BatuhanGunes/SmartBall/README(turkish).md

**Dil :** [English](https://github.com/BatuhanGunes/SmartBall) / Turkish

# Smart Ball

Bu proje, bir futbol takımı antrenörünün futbol takımı oyuncularını antreman sırasında takip edebilmesi için tasarlanmıştır. Özellikle pas ve şut antremanları sırasında isabet ve hız değerlerinin ölçümlenebilmesi amaçlanmıştır. Proje fiziksel ve yazılım olmak üzere iki kısımdan oluşmnaktadır. Fiziksel kısım sensörler ile topu algılayarak sonuçları yazılıma aktarmakta, yazılım kısmı ise gelen verileri işleyerek kaydetmektedir. Veriler yazılımın bulunduğu cihazda depolanır. Antremanlar gerçekleştirildikten sonra cihazda depolanan veriler her futbolcu için ayrı ayrı değerlendirilerek gelişimleri gözlemlenilebilir. Böylelikle antrenör takımını daha kolay analiz edebilmektedir.

```
Projenin oluşturulma tarihi : Haziran 2018
```

## Ekran Görüntüleri

   

    

 

## Başlangıç

Projeyi çalıştırabilmek için proje dosyalarının bir kopyasını yerel makinenize indirin. Gerekli ortamları ve elektronik malzemeleri edinin. Edindiğiniz malzemeler için gerekli devreyi kurun. Herhangi bir android cihaza yazılımı yükleyin. Yazılım üzerinden devre ile iletişimi sağlayın ve kullanmaya başlayın.

### Gereklilikler

- Devre için gerekli sensörler ve malzemeler
- Android yazılım sistemine sahip bir cihaz
- Android Studio
- Arduino
- Arduino IDE

Projeyi çalıştırabilmek için ilk olarak [Android Studio](https://developer.android.com/studio) adresinden sisteminize uygun IDE yazılımının herhangi bir sürümünü edinerek yerel makinenize kurun. Daha sonra yerel makinenize indirdiğiniz android yazılım için olan dosyaları bu ortamda açın. Gerekli ayarlamarı yaptıktan sonra uygulamanın apk uzantısını elde edin. Bu dosyayı android yazılıma sahip bir cihaza yükleyin.

Arduino için gerekli malzemeleri edinin ve devreyi oluşturun. Arduino için [Arduino IDE](https://www.arduino.cc/en/main/software) adresinden sisteminize uygun IDE yazılımının herhangi bir sürümünü edinerek yerel makinenize kurun. Arduino-pc bağlantısını gerçekleştirerek işlemciye arduino yazılımı arduino IDE ile yükleyin. Çalışır durumda olan devre ile uygulama arasında bluetooth bağlantısını oluşturun. uygulamayı kullanmak için yeni bir oyuncu oluşturun. Sistemi test etmek için oluşturulan oyuncu ile antremana başlayın. Bir top yardımıyla sistemi test edin.

## Yazarlar

* **Batuhan Güneş**  - [BatuhanGunes](https://github.com/BatuhanGunes)

Ayrıca, bu projeye katılan ve katkıda bulunanlara [contributors](https://github.com/BatuhanGunes/SmartBall/graphs/contributors) listesinden ulaşabilirsiniz.

## Lisans

Bu proje Apache lisansı altında lisanslanmıştır - ayrıntılar için [LICENSE.md](https://github.com/BatuhanGunes/SmartBall/blob/master/LICENSE) dosyasına bakabilirsiniz.
