BatuhanGunes/SmartBall/SmartBall_Description.pdf

Arduino projesi için araştırma

Proje başlangıcında belirli bir alana giren cismin hızının ölçülmesi, ölçülen değerlerin tablet veya telefon aracılığıyla kullanıcıya gösterilmesi amaçlandı. Örneğin bir futbolcu kaleye şut çekiyor ve antrenör futbol topunun kaleye hangi hızla girdiğini elindeki tabletten görebiliyor olacak. Bu projenin hayata geçirilebilmesi için hangi malzemelerin gerektiğini ve nasıl bir yol izlenmesi gerektiğinin belirlenmesi için araştırmalar yaptım

Araştırmalarım sonucunda yapılan kodlamaların derlenebilmesi için işlemci(Board) olarak arduino uno’yu seçtim. Herkesin de bildiği üzere herhangi bir cimin hızının ölçülebilmesi için cismin aldığı yolun ve bu yolu aldığı zamanın bilinmesi gerekmektedir. Kısacası cismin aldığı yolu ve zamanı hesaplayabileceğim sensörleri araştırmaya başladım.

Sensör araştırmalarım doğrultusunda Hc-Sr04 (ulturasonik mesafe sensörü) (Şekil 4.1), Ldr (foto direnç sensörü) (Şekil 4.2) ve HB100 (mikrodalga doppler radar sensörü) (Şekil 4.3) sensörlerinin projede kullanılabileceğini düşündüm. Cihaz ile tablet arasındaki iletişimi sağlamak için wi-fi ve bluetooth olmak üzere 2 seçenekten bluetooth modülünün proje için daha verimli olabileceğini düşündüm. Bluetooth modüllerini araştırdığımda Hc05 ve Hc06 olarak iki farklı modeli olduğunu gördüm. Bu modüller arasındaki farkları araştırdığımda Hc05 modülünün Hc06 modülünden farklı olarak kendi kendine iletişim başlatabileceğini bu yüzden Hc05 modülünün (Şekil 4.4) projeye daha uygun olacağını gördüm.

Bütün bu araştırmalarımın sonuçlarını raporlayarak, raporumu yetkili kişiye sundum. Verdiğim bilgiler doğrultusunda projeye nasıl devam etmemiz gerektiği, ne gibi malzemeler kullanmamız gerektiğini ve bu malzemelerin maliyetleri hakkında fikir alışverişinde bulunduk. Yaptığımız toplantı sonucunda 2 adet Hc-Sr04 (ulturasonik mesafe sensörü) ile 2 farklı noktada geçen cismi algılayıp bu iki nokta arasında geçen süreyi bulmak amaçlandı. Sensörler arasındaki mesafe bilindiği için buradan hız bulanabileceği sonucuna varıldı. Seçtiğim board ve bluetooth modülü uygun bulundu.

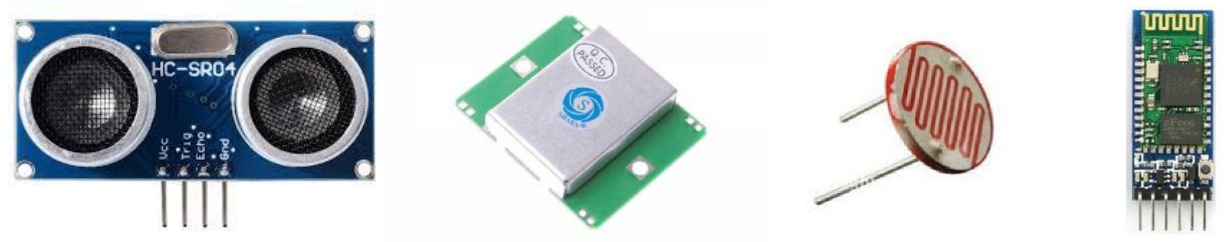
[picture p11: figure]

(Şekil 4.1) | (Şekil 4.2) | (Şekil 4.3) | (Şekil 4.4)

Devre şemasının çizilmesi ve malzemelerin alınması

Gerekli Malzemelerin belirlenmesinden sonra devre şemasını sanal ortamda modelledim (Şekil 5.1). Alınması gereken malzemeleri listeledim ve temin ettim. Alınan malzemeler;

- Arduino uno
- Hc-Sr04 (ulturasonik mesafe sensörü) x 2 adet
- Hc-05 (bluetooth modülü)
- Jumper erkek-erkek kablo
- Breadboard
- Dirençler

Alınan malzemeler, oluşturulan modelleme doğrultusunda breadboard üzerinde bağlantılarını gerçekleştirdim. Ardından arduino’nun programlanabilmesi için gereken yazılımsal ortamın yani Arduino IDE’nin kurulumunu yaptım. Sensörlerin ilk testi için gereken kodlamaları yaptım (Şekil 5.2). Yapılan kodlamaları arduino’ya yüklenip sensörlerin doğru çalışıp çalışmadığını, hassasiyetleri ve algı mesafelerini test ettim. Sorunsuz çalışan sensörler yetkili kişi tarafından da teste tabi tuttu. Yapılan testler sonucunda yüksek hızlarda sensörlerin topu görmediğini fark ettik.

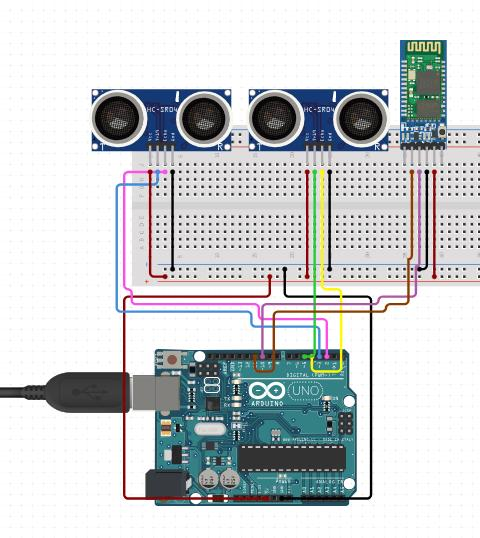
[picture p12: figure]
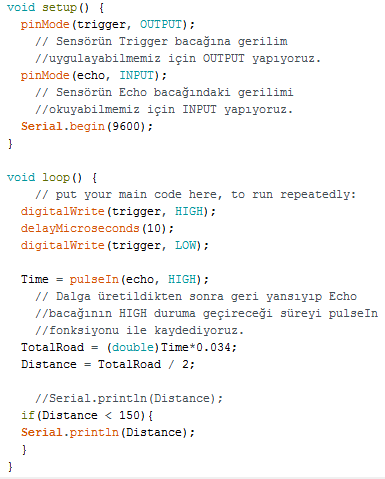
[picture p13: figure]

(Şekil 5.1) | (Şekil 5.2)

Çift sensör ile yatay düzlemede hız hesaplama

Yapılan testler sonucu sensörlerin cisimleri yüksek hızlarda göremediği tespit edilmişti. Bu hassasiyetin daha net ölçülebilmesi ve hangi hızlara kadar görüş sağladığını görmek amacıyla hız hesaplamalarına geçildi. Bunun için sensörlerin arasının ölçülüp 10cm’de sabitledikten sonra (Şekil 6.2) zaman tespiti için gerekli kodlarını yazdım. Milisaniye cinsinden bulunan zaman değerini saniyeye çevirip, kendi belirlediğim 10cm uzunluğa bölünmesi ile ölçülen hız değerlerini ekrana yazdırdım. Yapılan bu kodlamaların bir kısmı (Şekil 6.3 ve Şekil 6.4)’de görülebilir.

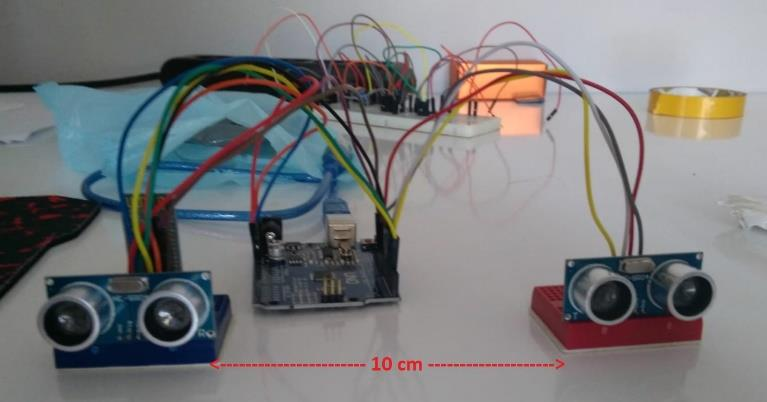
[picture p14: figure]
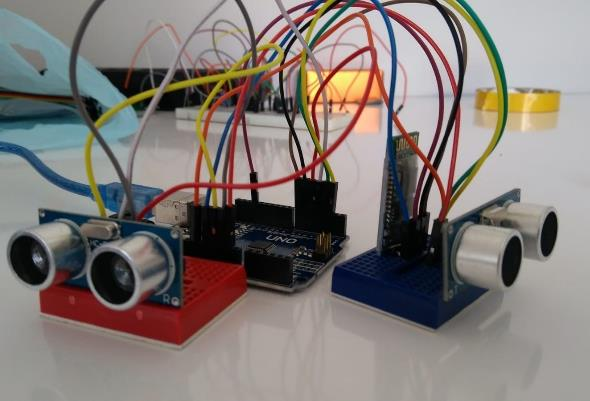
[picture p15: figure]

(Şekil 6.1) | (Şekil 6.2)

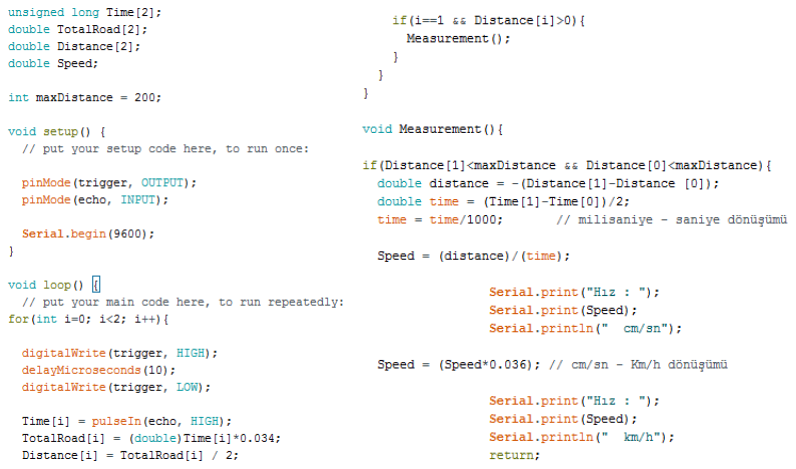
[picture p16: figure]

(Şekil 6.3) | (Şekil 6.4)

Tek sensör ile karşıdan gelen cismin hızını hesaplama

Yapılan sistem tekrar teste tabi tutuldu. Yapılan testler sonucu daha net görülmekte olan sensör hassasiyetinin, topu 15 km/h hızdan sonrasında nadiren gördüğü, 20 km/h hızdan sonra hiç görmediği fark edildi. Bunun üzerine Hc-Sr04 ulturasonik mesafe senörünün gelişmiş versiyonlarını araştırarak, bu sensörlerin fiyatları tartışıldı. Fiyatları fazla görülen bu sensörler projeye uygun görülmedi.

Sonuca ulaşmak için sensör değişikliği yerine sistemin çalışma prensibinin değiştirilebilirliği hakkında fikirler ürettim. Öne sürdüğüm bu fikirlerin içerisinden sensörün karşıdan gelen cisme odaklanması ve bunun üzerinden hız ölçümü yapmasını kararlaştırdım. Bu uygulamayı hayata geçirebilmek için araştırmalar yaptım.

Araştırmalarımın sonucunda sensörün karşıdan gelen cismi 2 kez algılayıp, cismin mesafelerini bir diziye atadıktan sonra uzaklıklar arasındaki farkı mesafe olarak kabul etmek ve cismin bu mesafeyi ne kadar zamanda geçtiğini ölçerek, cimin hızının bulmayı amaçladım. Bu doğrultuda gereken kodlar yazdım (Şekil 7.1 ve Şekil 7.2) ve devre üzerinde yapılması gereken değişiklikleri (Şekil 7.3) yaptım.

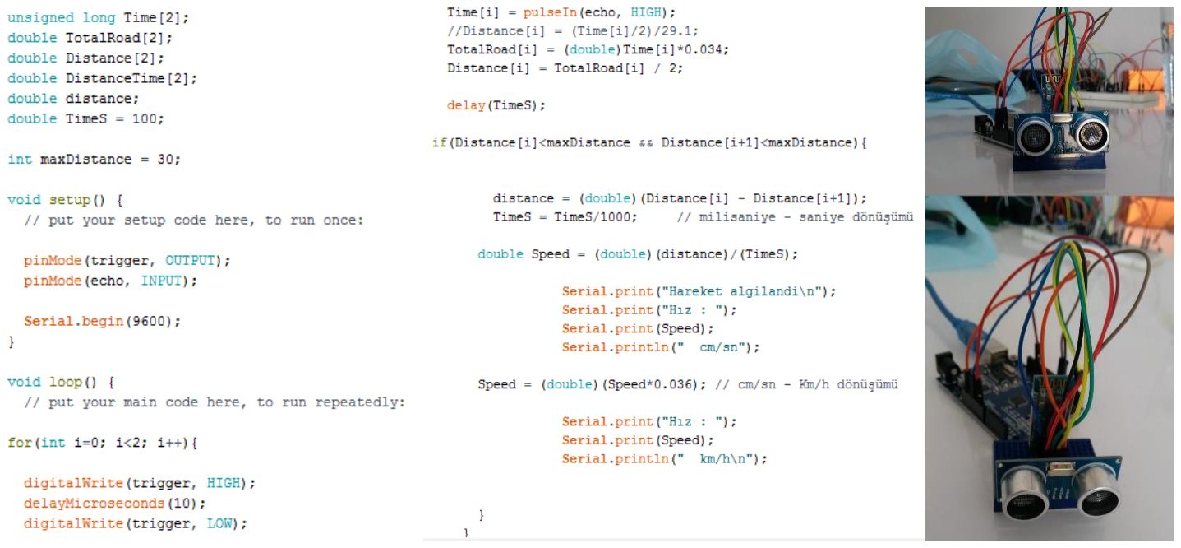
[picture p17: figure]

(Şekil 7.1) | (Şekil 7.2) | (Şekil 7.3)

Giriş-Çıkış sensör kontrol düzeni

X-bandında hız ölçen sistemin son düzenlemelerini yaptıktan sonra top ile test etme aşamasına geçtim. Yapılan testler doğrultusunda sensörün bu şekilde kullanılmasının algılamadaki hassasiyetini arttırdığı gözlemledim. Sensörün 20 km/h’den sonrasını nadiren, 30 km/h’den sonrasını hiç algılamadığını tespit ettim. Hassasiyetin arttırılması doğrultusunda algılama alanını daralttığını gözlemledim. Alanın daralması proje kapsamında maliyeti arttırmasından ve uygulanabilirliği azaltmasından dolayı bu yöntemden vazgeçildi.

Yapılan testler sonrasında projeye yeni problemlerin eklendiği ve bu problemler doğrultusunda nasıl bir çözüm yolu uygulanması gerektiği konusunda araştırmalar yaptım. Problemlerden biri olan algılama alanının nasıl arttırılabileceği yönünde sensörlerin arkalı önlü koyularak topun hem geliş yönünde hem de çıkış yönünde algılanmasıyla hassasiyetin ve alanın arttırılabileceğini ön gördüm.

Böylelikle sensörlerden biri topun ilk girişini algılayacak ve diğerinde çıkış yönünde bir algılama sağlayarak aradaki hız hesaplanacaktı. Bu doğrultuda proje için çalışmaya başladım. Gerekli devre düzenini kurup kodlar üzerindeki değişiklikleri (Şekil 8.1 ve Şekil 8.2) yaptım. Problemlerden bir diğeri olan uygulanabilirlik projenin ilerleyen aşamalarına bırakıldı.

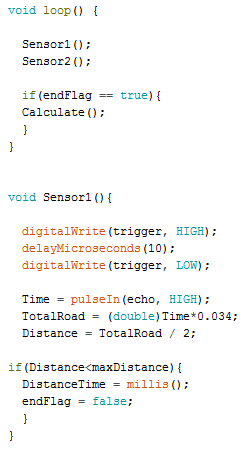
[picture p18: figure]
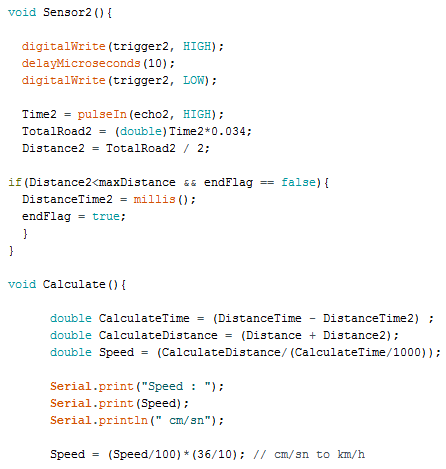
[picture p19: figure]

(Şekil 8.1) | (Şekil 8.2)

Arduino projesinin minyatür kalede test edilmesi

Yapılan giriş-çıkış algılama sisteminin hassasiyetinin ölçülebilmesi için minyatür kale üzerinde testlerine başladım. Sistemin minyatür kaleye montajından sonra topun hızı ölçülmeye başladım. Testler sonrasında kalenin en alt kısmından geçmekte olan cisimleri görmediği ve algı alanın yetersiz olmasından dolayı sistemin iyileştirilmesi için çalışmalar yapılması istenildi. Testler bitirilmeden önce sistem x-bandında ölçüm yapan tek sönsör haline çevrilerek kalenin arkasına koyulmasına ve test edilmesine karar verildi. Bu yöntem verimli olmadığı için iptal edildi.

Algı alanını genişletmek adına kalenin üst direğine aralarındaki mesafe 33cm olacak şekilde 3 adet sensör monte ettim (Şekil 9.1, Şekil 9.2, Şekil 9.3 ve Şekil 9.4). Aynı zamanda kodları iyileştirmek için çalıştım. Çalışmalar sırasında zaman tespitinde sorunlarla karşılaştım. Bu sorunları çözmeye çalıştım. Zamanlama sorunu çözüldükten sonra test aşamasına geçtim. Test sonuçlarının doğrultusunda verimli sonuç alamadım. Bunun üzerine kullanılan Hc-Sr04 ulturasonik mesafe sensörünün projeye uygun olup olmadığı tartışıldı.

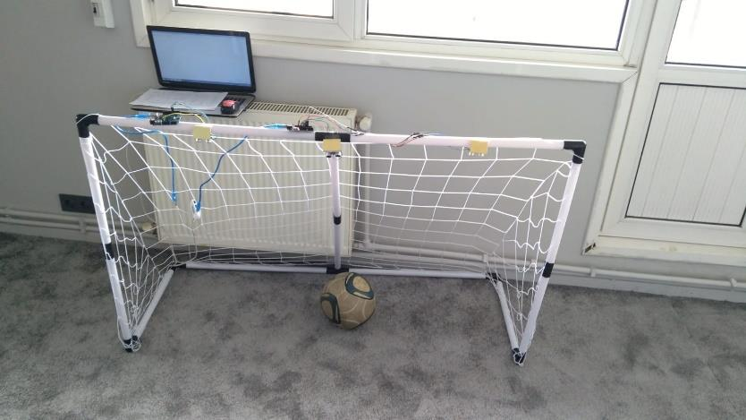
[picture p20: figure]
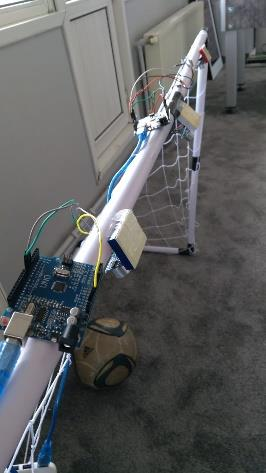
[picture p21: figure]

(Şekil 9.1) | (Şekil 9.2)

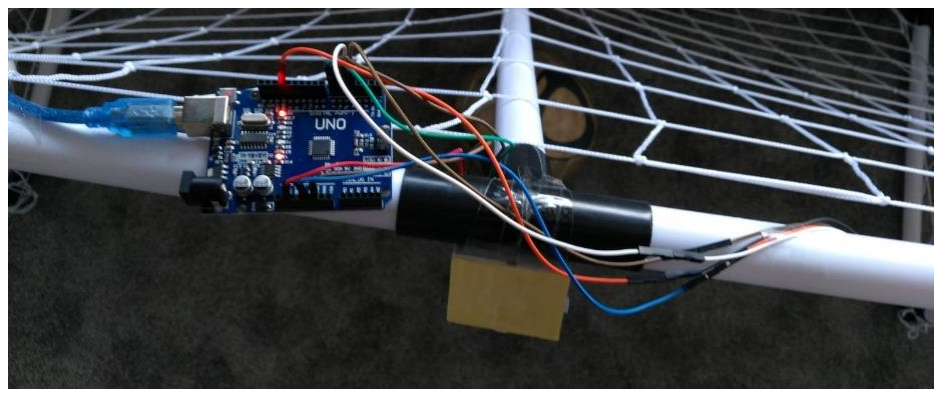
[picture p22: figure]
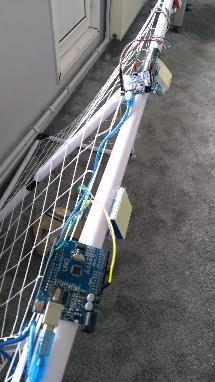
[picture p23: figure]

(Şekil 9.3) | (Şekil 9.4)

Farklı sensörlerin araştırılması ve ldr sensörünün testi

Sensörler istenilen hızları ölçmek için yeterli olmadığından kullanılan sensörlerin proje kapsamında doğru seçim olup olmadığı gündeme getirilmişti. Sensörün proje için doğru olup olmadığı araştırırken bir yandan da farklı sensörleri araştırmaya devam ettim.

Proje başında araştırılan sensörlerden LDR (light dependent resistor) sensörü için devre oluşturulup gerekli kodlamalar (Şekil 10.1 ve Şekil 10.2) yapıldı. Sensörün ışık ortamıyla birebir etkileşimi olduğundan sensörün dış ortamda kullanılamayacağı kararlaştırıldı. Dış ortama uygun olması adına sistemin ilk 1 milisaniyesinde ortamın ışık oranının, ortalamasının alınıp hesaplamaya aktarılması fikrini öne sürdüm fakat yöntemin sağlıksız olacağı, bu yüzden ldr (Foto direnç) sensörünün projeye uygun olmadığı kararlaştırıldı. Bunun üzerine proje için tekrar yeni sensörler araştırmaya başladım.

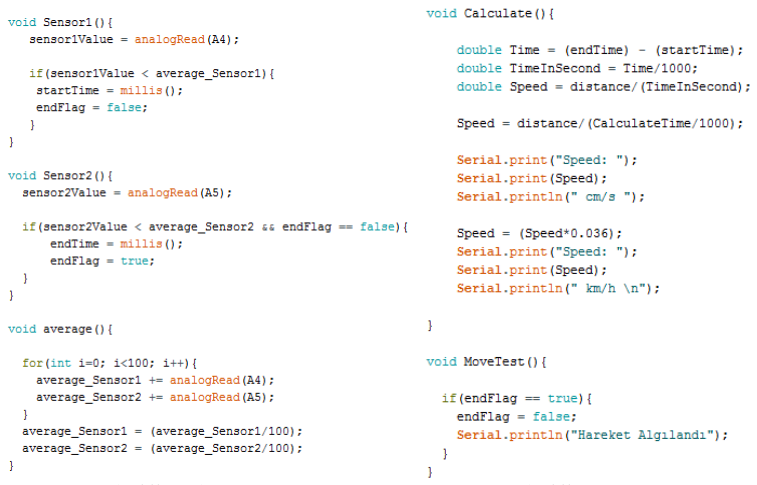
[picture p24: figure]

(Şekil 10.1) | (Şekil 10.2)

Hb100 mikrodalga doppler sensörü ile hız ölçümü

Tekrar arduino projesine döndüm. Proje için uygun sensör aramaya başladım. Araştırmalarım sonrasında Hb100 mikrodalga doppler radar sensörünün kullanılmasına karar verdim. Hb100 ve arduino ile yapılmış olan radar silahı projelerini araştırdım ve örnek aldım. Radar silah projelerinin projemize uygulanabilirliğini kontrol ettim.

Hb100’ün sinyal yayması için gerekli amfi devresi tasarımlarını inceledim. Devre şeması çıkarttım (Şekil 13.1). Arduino’ya uyumlu versiyonunu bulamadığım için cihaza pinler lehimleyerek uygun hale getirdim (Şekil 13.2). Gerekli bağlantıları breadboard üzerinde oluşturduktan (Şekil 13.3) sonra kodlarını yazılmaya başladım (Şekil 13.4). Devrenin testini gerçekleştirdim. Testler sonucu verilerin yanlış geldiğini tespit ettim.

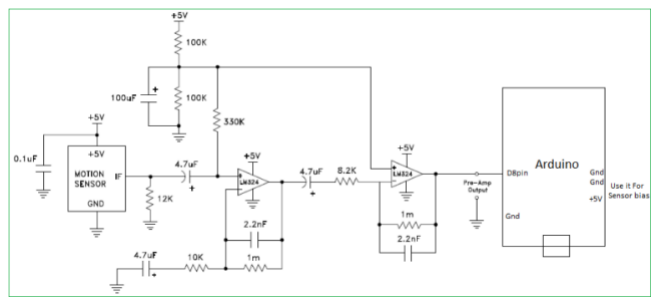
[picture p25: figure]

(Şekil 13.1)

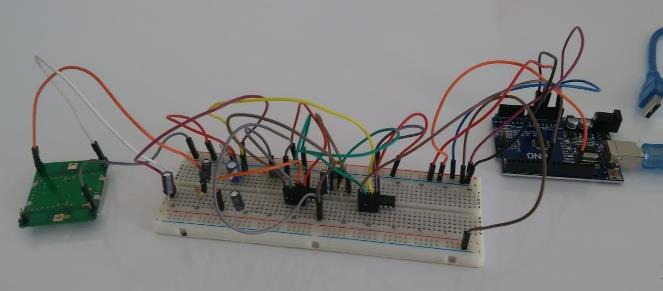
[picture p26: figure]
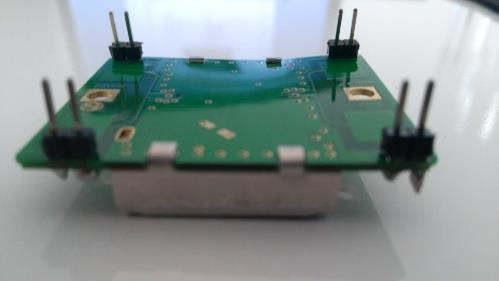
[picture p27: figure]

(Şekil 13.2) | (Şekil 13.3)

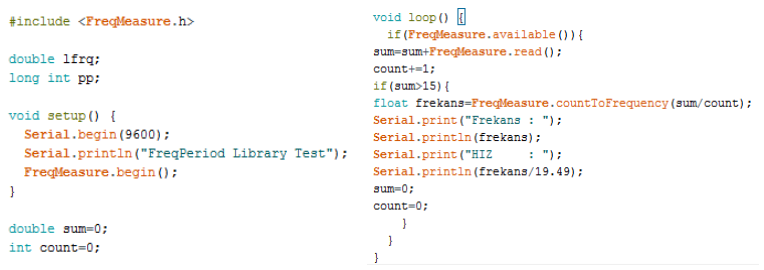
[picture p28: figure]

(Şekil 13.4)

Hb100 hatalarının tespiti ve Pır Sensörü

Hb100 mikrodalga doppler sensöründen veri alamadım. Zaman zaman aldığım verilerin ise hatalı olduğunu belirledim. Bunun sebeplerini araştırdım. Devre bağlantılarını kontrol ettim. Kodları kontrol ettim. Bir sorunla karşılaşmadım ve hatanın nedeni bulamadım. Bu yüzden devreyi breadboard üzerinde sıfırdan yapmaya başladım. Bağlantıları tekrar kontrol ettim. Fakat sonuç değişmedi. Multimetre ile bağlantıları kontrol ettim. Verilerin yanlış gelmesinin nedenini bulamadım. Bu sorunun nedeni üzerine araştırmamalar yaptım. Araştırmalar sonrasında nedeni bulunamayan hatalardan dolayı Hb100 projeden çıkarıldı.

Hb100 kullanılmaktan vazgeçilerek yerine HC-SR501 ayarlanabilir IR hareket sensörü (PIR) kullanılmasına karar verildi. Bunun için gerekli araştırmaları yaptım. Çalışma prensibini araştırdım (Şekil 14.1 ve Şekil 14.2). Sensörü tedarik ettim. Sensör zaman ve hassasiyet anahtarlarını en düşüğe alarak “I” moduna ayarladım. İlk testler için gerekli bağlantıları yaptım (Şekil 14.3) ve sensörün algılama kapasitesini ölçmek için gerekli kodları yazdım (Şekil 14.3).

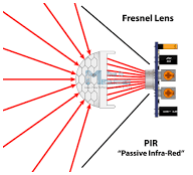
[picture p29: figure]
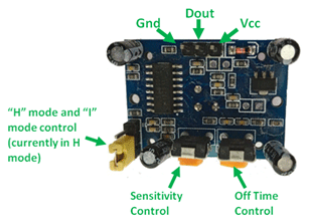
[picture p30: figure]

(Şekil 14.1) | (Şekil 14.2)

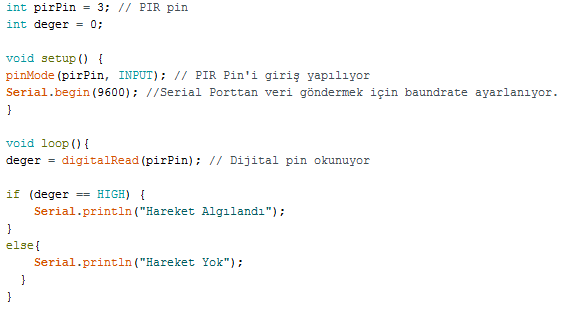
[picture p31: figure]
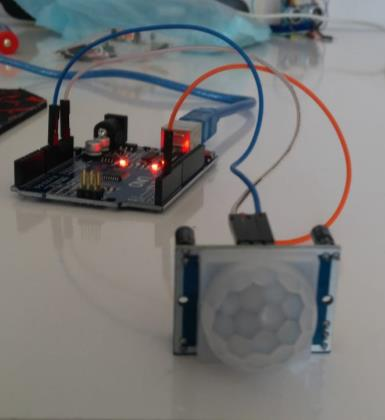
[picture p32: figure]

(Şekil 14.3) | (Şekil 14.3)

Hareketin süresini tutma ve Monster Notebook akışı

PIR Sensörü ile algılama kapasitesini ölçtükten sonra önünden geçen cismin hareketini ne kadar sürede bitirdiğini hesaplamaya geçtim. Bunun için kodlamalar yaptım (Şekil 15.1). Fakat PIR sensörünün çalışma prensibinden kaynaklanan sayma özelliği hareketin bitmesinden sonra 4 saniye daha high konumunda kalmasına neden olmaktaydı. Bu durum hız hesaplarken sorun çıkartacağından dolayı hesaplama sırasında bulunan süreden 4 saniye çıkartarak işlem yaptım. Hesaplamada uyguladığım bu yöntem cihazın 4 saniyelik bir gecikme ile cevap vermesine yol açtı. Gecikmeyi nasıl önleyebileceğim hakkında çalışmalara başladım. Aynı zamanda projenin nasıl devam etmesi gerektiğine ilişkin yetkili kişilerden fikirler aldım.

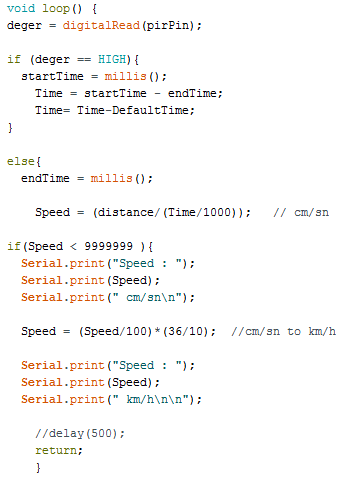
[picture p33: figure]

(Şekil 15.1)

Android uygulaması ile bluetooth cihazına bağlanma

Android Studio yükleyerek SmartBall adlı bir uygulama oluşturmaya başladım. Açılış sayfasında butonlar koyarak butonların farklı activity’lere geçiş yapmalarını sağladım. Arduino’dan gelen verileri işleme sokmak için ilk olarak uygulama ile Ardiuno’nun bluetooth modülünün (Hc-05) telefon ile eşleşmesini sağlamak için gerekli kodları yazdım (Şekil 16.1). Uygulamanın bluetooth özelliğini kullanabilmesi için gerekli izinleri kodladım. Yapılan işlemler sonucunda uygulamanın çalışma esnasında telefonun önceden eşleştirilmiş bluetooth cihazlarını görebilmesi ve bu cihazlara bağlanmasını sağladım. Oluşabilecek hatalardan bluetooth cihazına bağlanamama, telefonun bluetooth özelliğinin kapalı olması veya uygulamanın çalışması sırasında bağlantının kopması gibi durumların hata vermesi durumlarında uygulanılacak senaryolar oluşturdum ve bu senaryoları kodladım (Şekil 16.2).

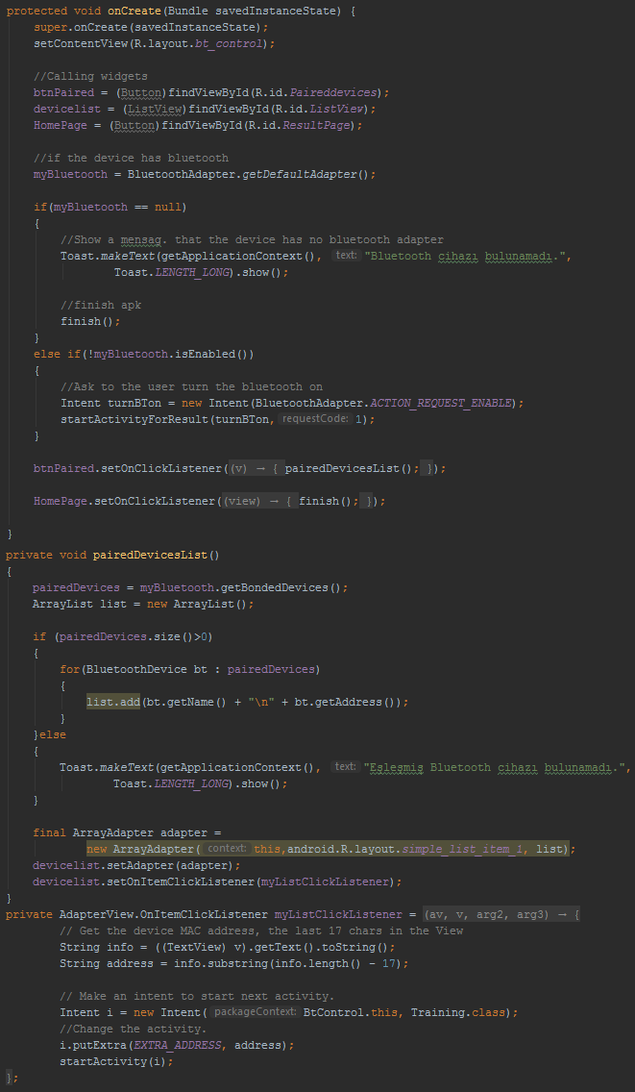
[picture p34: figure]
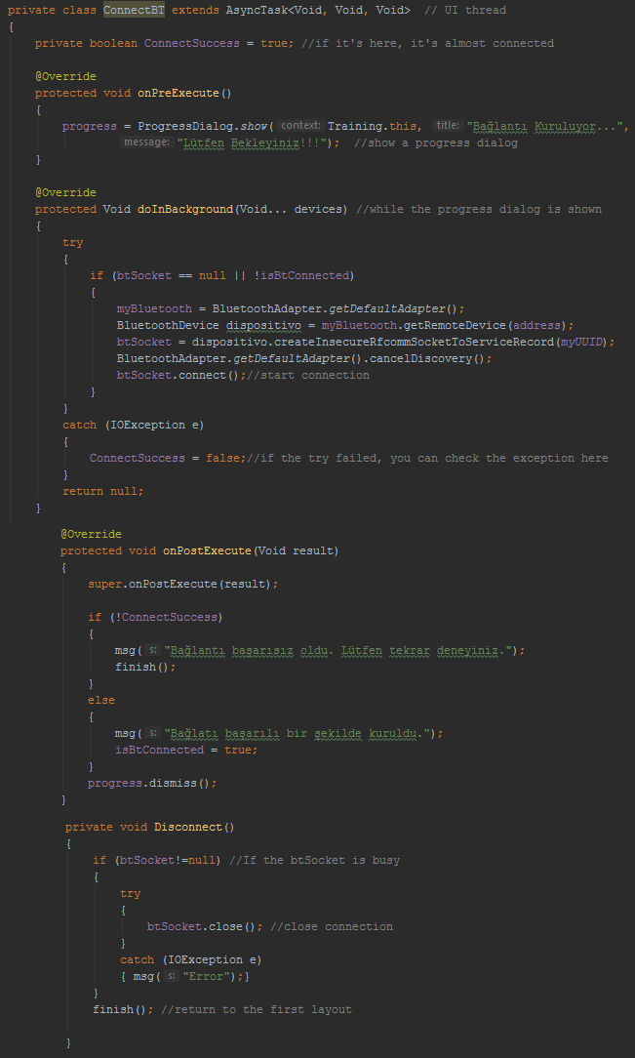
[picture p35: figure]

(Şekil 16.1) | (Şekil 16.2)

Android uygulamasında SQLite işlemleri

Uygulama içerisinde SQLite ile yeni bir veri tabanı ve bu veri tabanına bağlı 2 adet tablo oluşturdum (Şekil 17.1). Bu tablolardan ilki uygulama içerisindeki kişilerin verilerini, diğeri ise bu kişilerin antrenman bilgilerini tutmaktadır. Bu tablolara veri ekleme, veri silme, güncelleme ve listeleme işlemlerini gerçekleştirmek için gerekli kodlamaları yaptım. Daha sonra bu işlemlerin kullanıcı tarafından görülebilecek ve kullanabilecek haline getirdim (Şekil 17.2). Bu işlemlerin ön taraftaki activity tasarımlarını yaptım (Şekil 17.3).

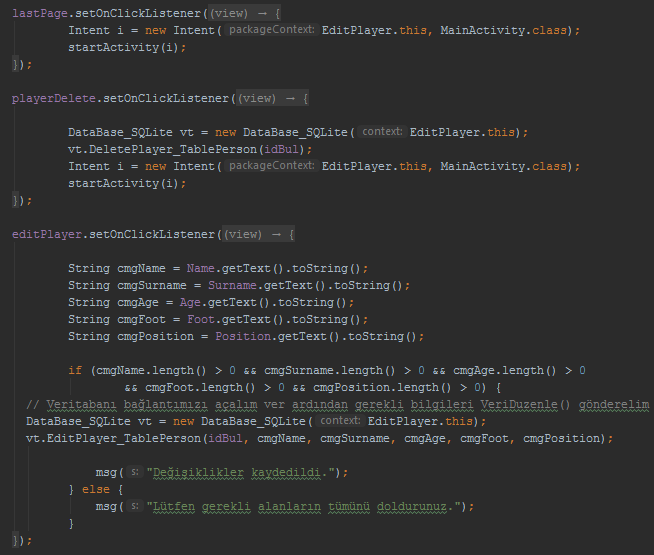
[picture p36: figure]
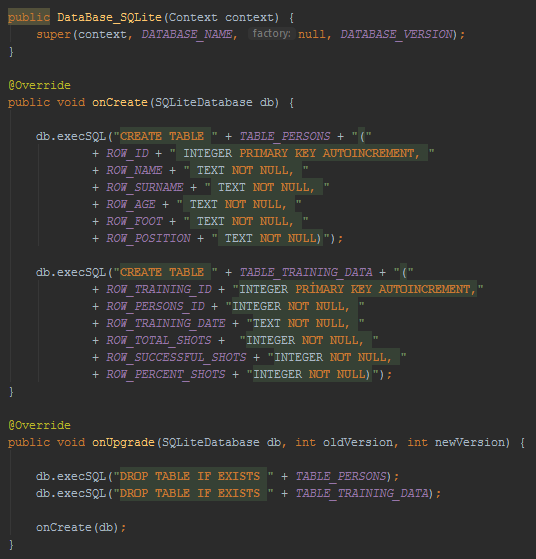
[picture p37: figure]

(Şekil 17.1) | (Şekil 17.2)

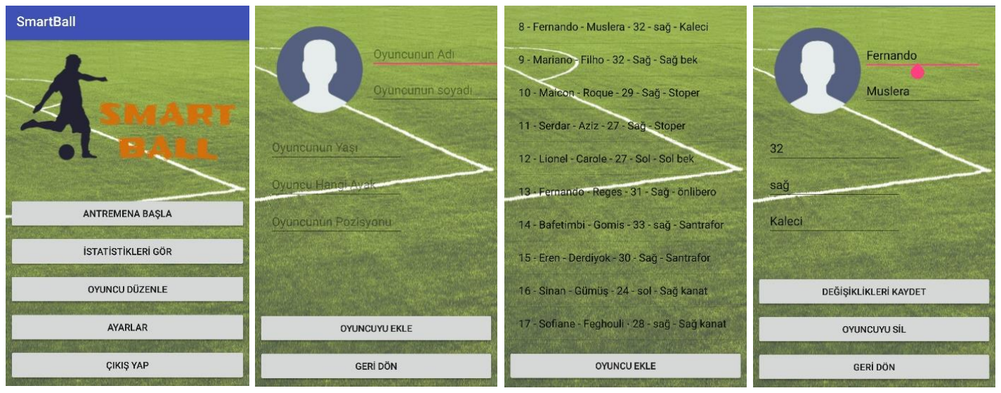
[picture p38: figure]

(Şekil 17.3)

Arduino verilerinin işlenmesi ve uygulama tasarımı

Arduino ile oluşturduğum sistem algı alanından bir nesne geçmesini algılamaktaydı. Bu cihazı kalenin üst kısmana ekleyerek kaleye giren topların hareketini algılayıp, verileri android projemize aktarıp oyunculara göre tutmak amaçlanmıştı. Bunun için oyuncuları tutma işlemlerini daha önceden gerçekleştirdik.

Sırada gelen verileri oyunculara göre tutma ve bunları listeleme işlemi kaldı. Bir panel oluşturarak (Şekil 18.1) antrenmanı başlatıp bitirdiğimizde toplam isabetli şut sayısını, toplam şut sayısını, antrenmanın yapıldığı tarihi, oyuncuyu ve isabet yüzdesi verilerini işlemlere sokup genel sonuçları kullanıcıya göstermek için gerekli kodlamaları yaptım (Şekil 18.2). Aynı zamanda kullanıcının bu zamana kadar yapılan tüm antrenmanları oyunculara göre gözlemleyebileceği bir panel de hazırladım. Uygulamanın genel tasarımı ile ilgili iyileştirilmeler yaptım.

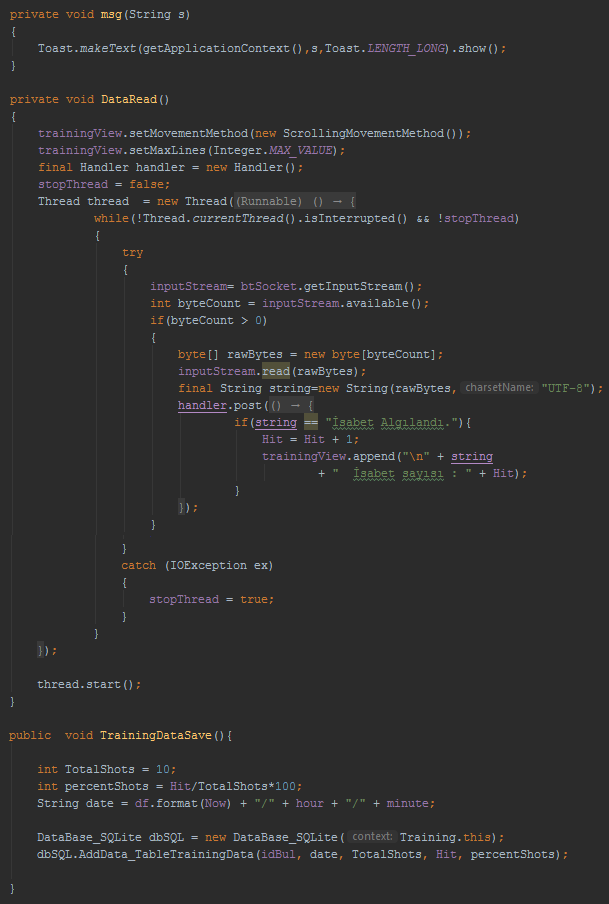
[picture p39: figure]
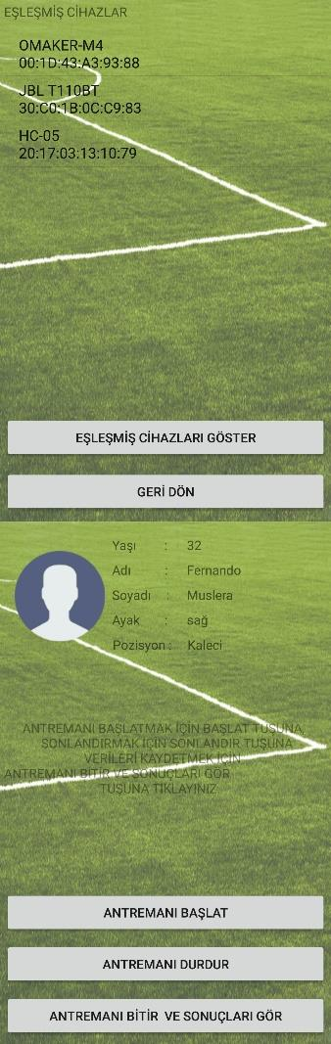
[picture p40: figure]

(Şekil 18.1) | (Şekil 18.2)

SmartBall uygulamasının son haline getirilmesi

Uygulamanın son halini alması için bütün ekran geçişlerini test ettim ve erkan geçişleri test ederken fark edilen tasarımsal hataları düzelttim. Uygulamanın menü iconlarını tasarladım ve 4 farklı boyut için uygulamanın içine gömdüm. Oyuncu ekleme ve düzenleme kısımlarında oyuncunun fotoğrafının eklenebileceği bir alan yaptım. Bu alana telefonun galerisinden veya kamerasından fotoğraf eklenebilmesini (Şekil 19.1), eklenilen fotoğrafın kullanıcı tarafından kırpılmasını (Şekil 19.2) sağladım. Kırpılmış şekilde alınan fotoğrafın son halini byte tipinde bir değişkene çevirerek veri tabanına kaydettim. Tekrar fotoğrafın gösterileceği zaman ise byte tipine çevirme işleminin tam tersini uygulayarak fotoğrafın ekrana yazdırılmasını sağladım. Fotoğraf seçiminde hangi işlemin yapılması istenildiğini soran (Şekil 19.3) bir alan oluşturdum. Bluetooth işlemleri sırasında bekletilen kısımlar için (Şekil 19.4) veya bluetooth seçeneğinin açılması için (Şekil 19.5) bilgiler gönderdim.

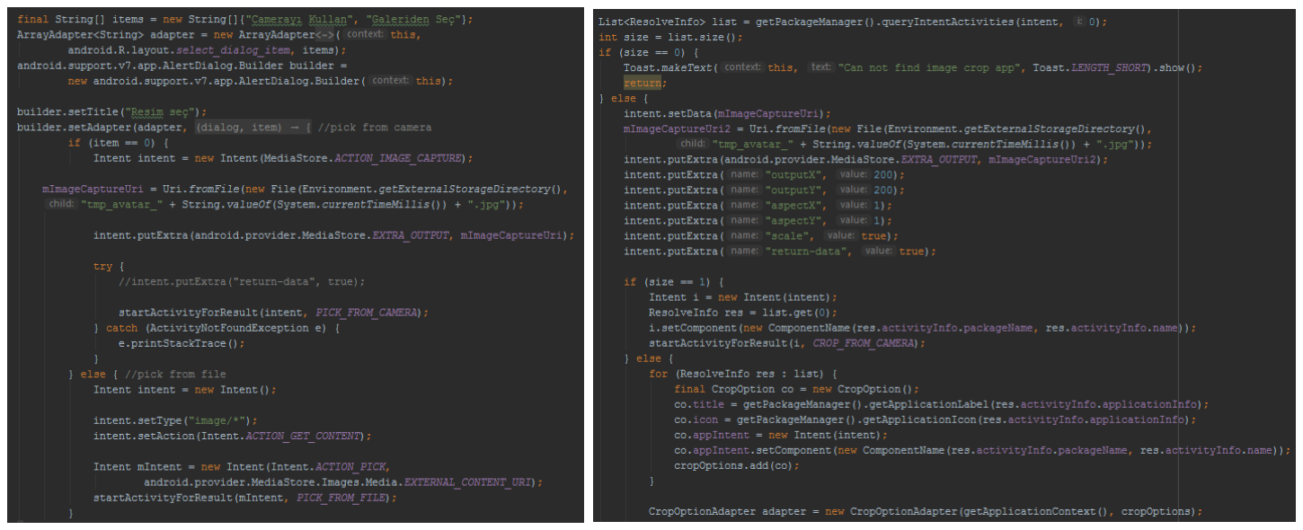
[picture p41: figure]

(Şekil 19.1) | (Şekil 19.2)

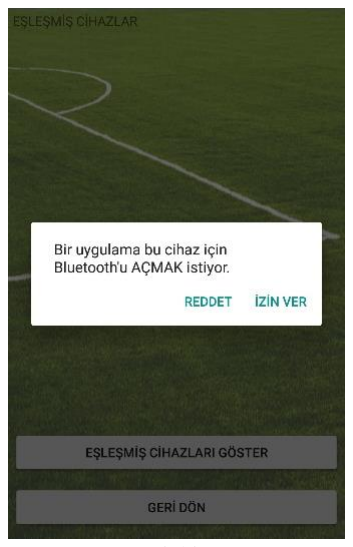
[picture p42: figure]
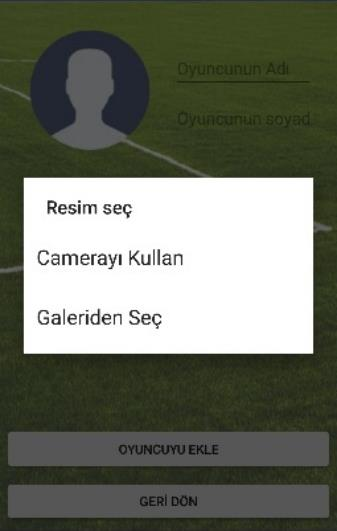
[picture p43: figure]
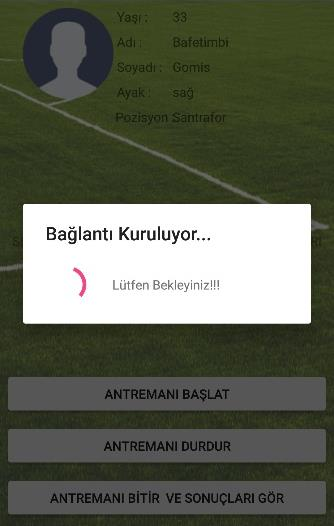
[picture p44: figure]

(Şekil 19.3) | (Şekil 19.4) | (Şekil 19.5)
